frisnit/Arduino-Eprom-Writer/bin2c/README.md

# bin2c
Create a 'C' array from a binary file

Compile the program by typing `cc bin2c.c -o bin2c`

Convert a file by typing `bin2c <binaryfile>`

The program will create a file called `<binaryfile>.c`

Copy the contents to the file 'image.h' in the Arduino EPROM writer.
