frisnit/Arduino-Eprom-Writer/(threads)

Thread 4 (2021-10-05):

Eprom writer

poll11, 2021-10-05:
Schematic how eprom with arduino wired pin to pin?  and type uno nano mega for this programmer sorry my english is bad
