frisnit/Arduino-Eprom-Writer/eprom-writer/image.h

#define DATA_LENGTH 0x0000
const PROGMEM byte ROM_DATA[DATA_LENGTH]=
{
	// put your EPROM image data here...
	// you can generate the contents of this file from a binary image
	// using the bin2c program included in this repo
};
