frisnit/Arduino-Eprom-Writer/(commit log)

2016-09-08 added support for 2516 devices
2022-01-12 added schematic and image
